WookyDO/Cerbo-alde/hardware/BOM.csv

Referenzen | Anzahl | Wert | Footprint | LCSC | Hersteller-Teil | Hersteller | Bestueckung
SW1, SW2 | 2 | B3U-1000P | SW_SPST_B3U-1000P | C231329 | B3U-1000P | Omron | JLCPCB
D3 | 1 | B5819W | D_SOD-123 | C109213 | B5819W | MDD | JLCPCB
R5, R17 | 2 | 4.7kΩ | R_0603_1608Metric | C23162 | 0603WAF4701T5E | UNI-ROYAL | JLCPCB
C6, C7 | 2 | 22uF 25V X5R | C_1206_3216Metric | C12891 | CL31A226KAHNNNE | Samsung | JLCPCB
U1 | 1 | ESP32-C3 Modul | ESP32-C3-WROOM-02 |  | ESP32-C3-WROOM-02-N4 | Espressif | selbst beschaffen/loeten
C1, C4, C5, C8, C9, C13, C17 | 7 | 100nF 50V X7R | C_0603_1608Metric | C14663 | CC0603KRX7R9BB104 | YAGEO | JLCPCB
R6, R8, R9, R10, R11, R18 | 6 | 10kΩ | R_0603_1608Metric | C25804 | 0603WAF1002T5E | UNI-ROYAL | JLCPCB
J4 | 1 | Stiftleiste 1x6 2,54 mm | PinHeader_1x06_P2.54mm_Vertical |  | PREC006SAAN-RC | Sullins | selbst beschaffen/loeten
JP1 | 1 | Stiftleiste 1x2 2,54 mm | PinHeader_1x02_P2.54mm_Vertical |  | PREC002SAAN-RC | Sullins | selbst beschaffen/loeten
C3, C16 | 2 | 10uF 50V X7R | C_1210_3225Metric | C138687 | CL32B106KBJNNNE | Samsung | JLCPCB
R13, R14 | 2 | 5.1kΩ | R_0603_1608Metric | C23186 | 0603WAF5101T5E | UNI-ROYAL | JLCPCB
J2, J5 | 2 | Schraubklemme 3-pol. 5,08 mm | TerminalBlock_Phoenix_MKDS-1,5-3-5.08_1x03_P5.08mm_Horizontal |  | 1715734 | Phoenix Contact | selbst beschaffen/loeten
J6, J7 | 2 | RJ12 6P6C liegend | TYCO_5555165-1 |  | 5555165-1 | TE Connectivity | selbst beschaffen/loeten
D5, D8 | 2 | PESD1LIN | D_SOD-323 | C393615 | PESD1LIN | DOWO | JLCPCB
F1 | 1 | PTC 0.5A 60V | Fuse_1812_4532Metric | C19078719 | 1812L050/60GR | Littelfuse | JLCPCB
L2 | 1 | 3.9uH | L_Bourns-SRN4018 | C96899 | SWPA4030S3R9MT | Sunlord | JLCPCB
J3 | 1 | TYPE-C-31-M-12 | USB_C_Receptacle_HRO_TYPE-C-31-M-12 | C165948 | TYPE-C-31-M-12 | Korean Hroparts | JLCPCB
C2 | 1 | 47uF 35V | CP_Elec_6.3x7.7 | C122665 | VEJ470M1VTR-0607 | Lelon | JLCPCB
U4 | 1 | USBLC6-2SC6 | SOT-23-6 | C21713975 | USBLC6-2SC6 | ST | JLCPCB
D4 | 1 | 1N4148W | D_SOD-123 | C109203 | 1N4148W | MDD | JLCPCB
R3 | 1 | 15kΩ | R_0603_1608Metric | C22809 | 0603WAF1502T5E | UNI-ROYAL | JLCPCB
U3, U5 | 2 | TJA1021T/20 | SOIC-8_3.9x4.9mm_P1.27mm | C128810 | TJA1021T/20/CM,118 | NXP | JLCPCB
D6 | 1 | LED green | LED_0603_1608Metric | C125094 | LTST-C190KGKT | Lite-On | JLCPCB
D1 | 1 | SS34 | D_SMA | C115205 | SS34 | MDD | JLCPCB
C11 | 1 | 1nF/50V | C_0603_1608Metric | C1588 | CL10B102KB8NNNC | Samsung | NICHT bestuecken
R7 | 1 | 1kΩ 0.25W | R_1206_3216Metric | C4410 | 1206W4F1001T5E | UNI-ROYAL | JLCPCB
L1 | 1 | 10uH | L_Bourns_SRN6045TA | C135304 | SMNR6045-100MT | Sunlord | JLCPCB
U2 | 1 | AP63203WU-7 | TSOT-23-6 | C780769 | AP63203WU-7 | Diodes | JLCPCB
C10, C18 | 2 | 220pF 50V X7R | C_0603_1608Metric | C1603 | CL10B221KB8NNNC | Samsung | JLCPCB
D2 | 1 | SMBJ18CA | D_SMB | C113991 | SMBJ18CA | Littelfuse/LGE | JLCPCB
C12 | 1 | 10uF 25V X5R | C_0805_2012Metric | C15850 | CL21A106KAYNNNE | Samsung | JLCPCB
C14, C15 | 2 | 1uF 50V X5R | C_0603_1608Metric | C15849 | CL10A105KB8NNNC | Samsung | JLCPCB
R2 | 1 | 100kΩ | R_0603_1608Metric | C25803 | 0603WAF1003T5E | UNI-ROYAL | JLCPCB
D7 | 1 | LED red | LED_0603_1608Metric | C2286 | KT-0603R | Hubei KENTO | JLCPCB
R4, R12 | 2 | 1kΩ | R_0603_1608Metric | C21190 | 0603WAF1001T5E | UNI-ROYAL | JLCPCB
J1 | 1 | Schraubklemme 2-pol. 5,08 mm | TerminalBlock_Phoenix_MKDS-1,5-2-5.08_1x02_P5.08mm_Horizontal |  | 1715721 | Phoenix Contact | selbst beschaffen/loeten
