WookyDO/Cerbo-alde/hardware/gehaeuse/Rev4_Deckel.stl

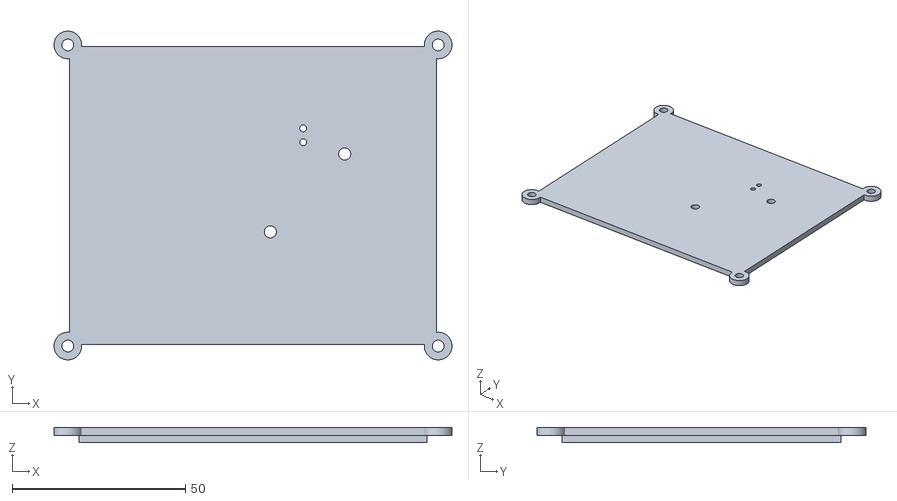
[picture p1: CAD file, 2026-11-14]
hardware/gehaeuse/Rev4_Deckel.stl
115.0 x 95.0 x 4.40
