WookyDO/Cerbo-alde/hardware/gehaeuse/Rev4_Unterteil.stl

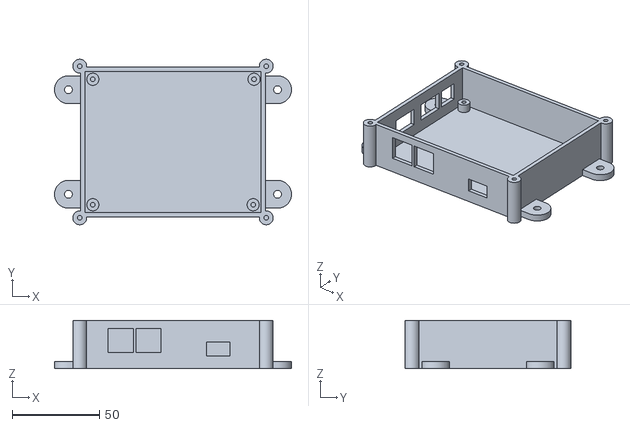
[picture p2: CAD file, 2026-11-14]
hardware/gehaeuse/Rev4_Unterteil.stl
136.0 x 95.0 x 27.6
