WookyDO/Cerbo-alde/hardware/Schaltplan.pdf

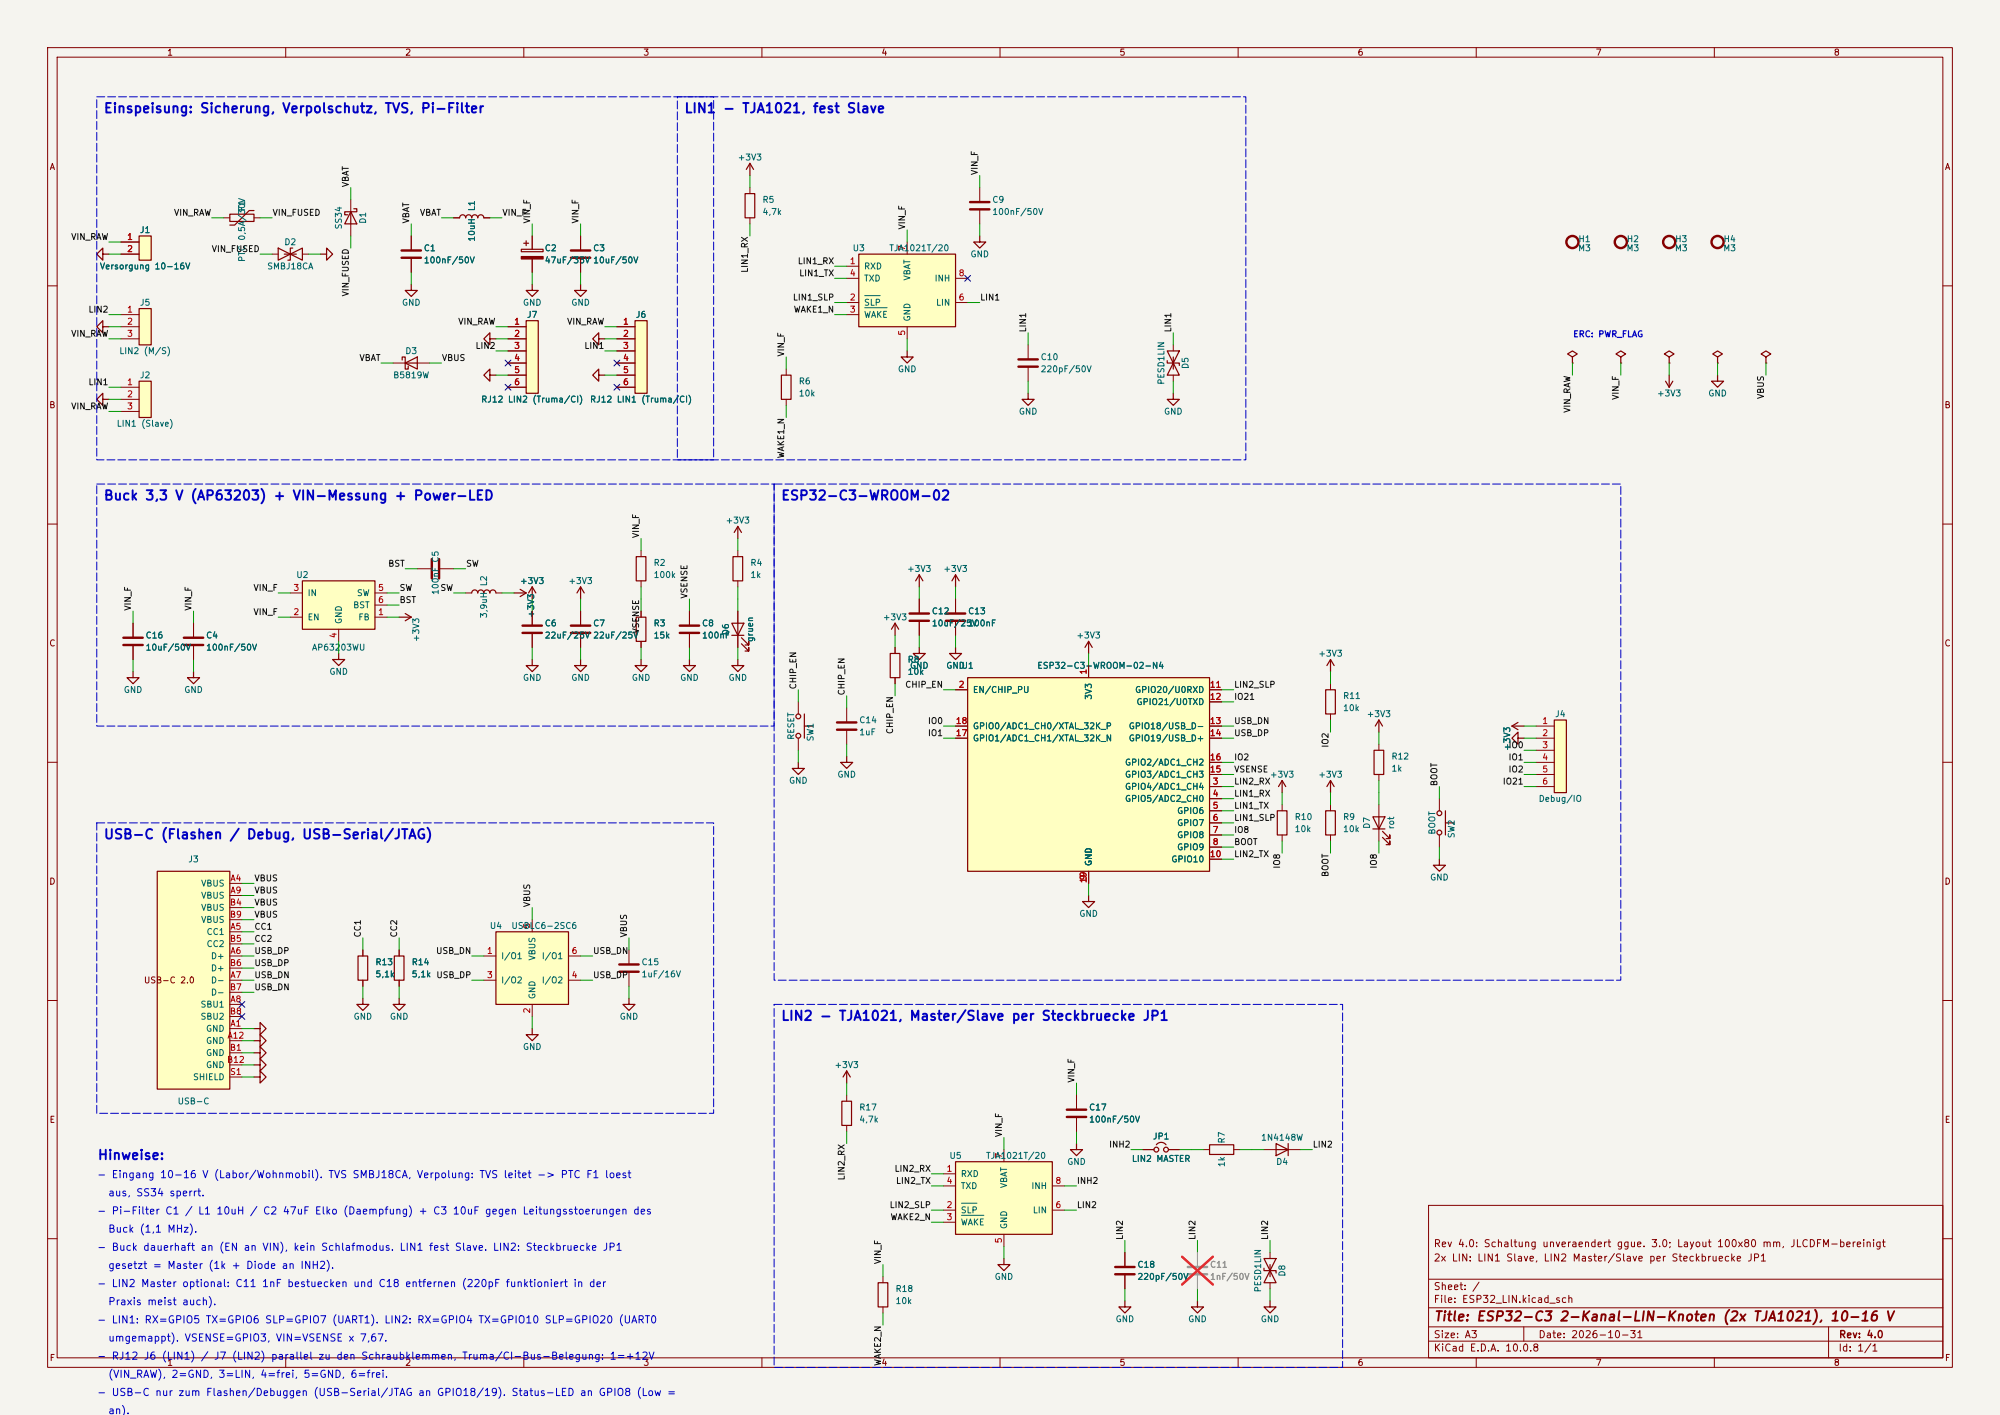
[picture p3: page 1]

Einspeisung: Sicherung, Verpolschutz, TVS, Pi-Filter

Buck 3,3 V (AP63203) + VIN-Messung + Power-LED

IO21 - RJ12 J6 (LIN1) / J7 (LIN2) parallel zu den Schraubklemmen, Truma/CI-Bus-Belegung: 1=+12V - Eingang 10-16 V (Labor/Wohnmobil). TVS SMBJ18CA, Verpolung: TVS leitet -> PTC F1 loest

USB-C (Flashen / Debug, USB-Serial/JTAG)
J3 USB-C

LIN2 - TJA1021, Master/Slave per Steckbruecke JP1

Hinweise: - LIN1: RX=GPIO5 TX=GPIO6 SLP=GPIO7 (UART1). LIN2: RX=GPIO4 TX=GPIO10 SLP=GPIO20 (UART0 - LIN2 Master optional: C11 1nF bestuecken und C18 entfernen (220pF funktioniert in der - Buck dauerhaft an (EN an VIN), kein Schlafmodus. LIN1 fest Slave. LIN2: Steckbruecke JP1

Buck (1,1 MHz). aus, SS34 sperrt. - USB-C nur zum Flashen/Debuggen (USB-Serial/JTAG an GPIO18/19). Status-LED an GPIO8 (Low =
umgemappt). VSENSE=GPIO3, VIN=VSENSE x 7,67. - Pi-Filter C1 / L1 10uH / C2 47uF Elko (Daempfung) + C3 10uF gegen Leitungsstoerungen des

Rev 4.0: Schaltung unveraendert ggue. 3.0; Layout 100x80 mm, JLCDFM-bereinigt
2x LIN: LIN1 Slave, LIN2 Master/Slave per Steckbruecke JP1

gesetzt = Master (1k + Diode an INH2).

Sheet: /
File: ESP32_LIN.kicad_sch
Title: ESP32-C3 2-Kanal-LIN-Knoten (2x TJA1021), 10-16 V

Size: A3 | Rev: 4.0 | F Date: 2026-10-31
KiCad E.D.A. 10.0.8 | Id: 1/1

(VIN_RAW), 2=GND, 3=LIN, 4=frei, 5=GND, 6=frei.
