WookyDO/Cerbo-alde/hardware/ESP32_LIN.kicad_pcb

## KiCad design hardware/ESP32_LIN.kicad_pcb (2026-11-10)

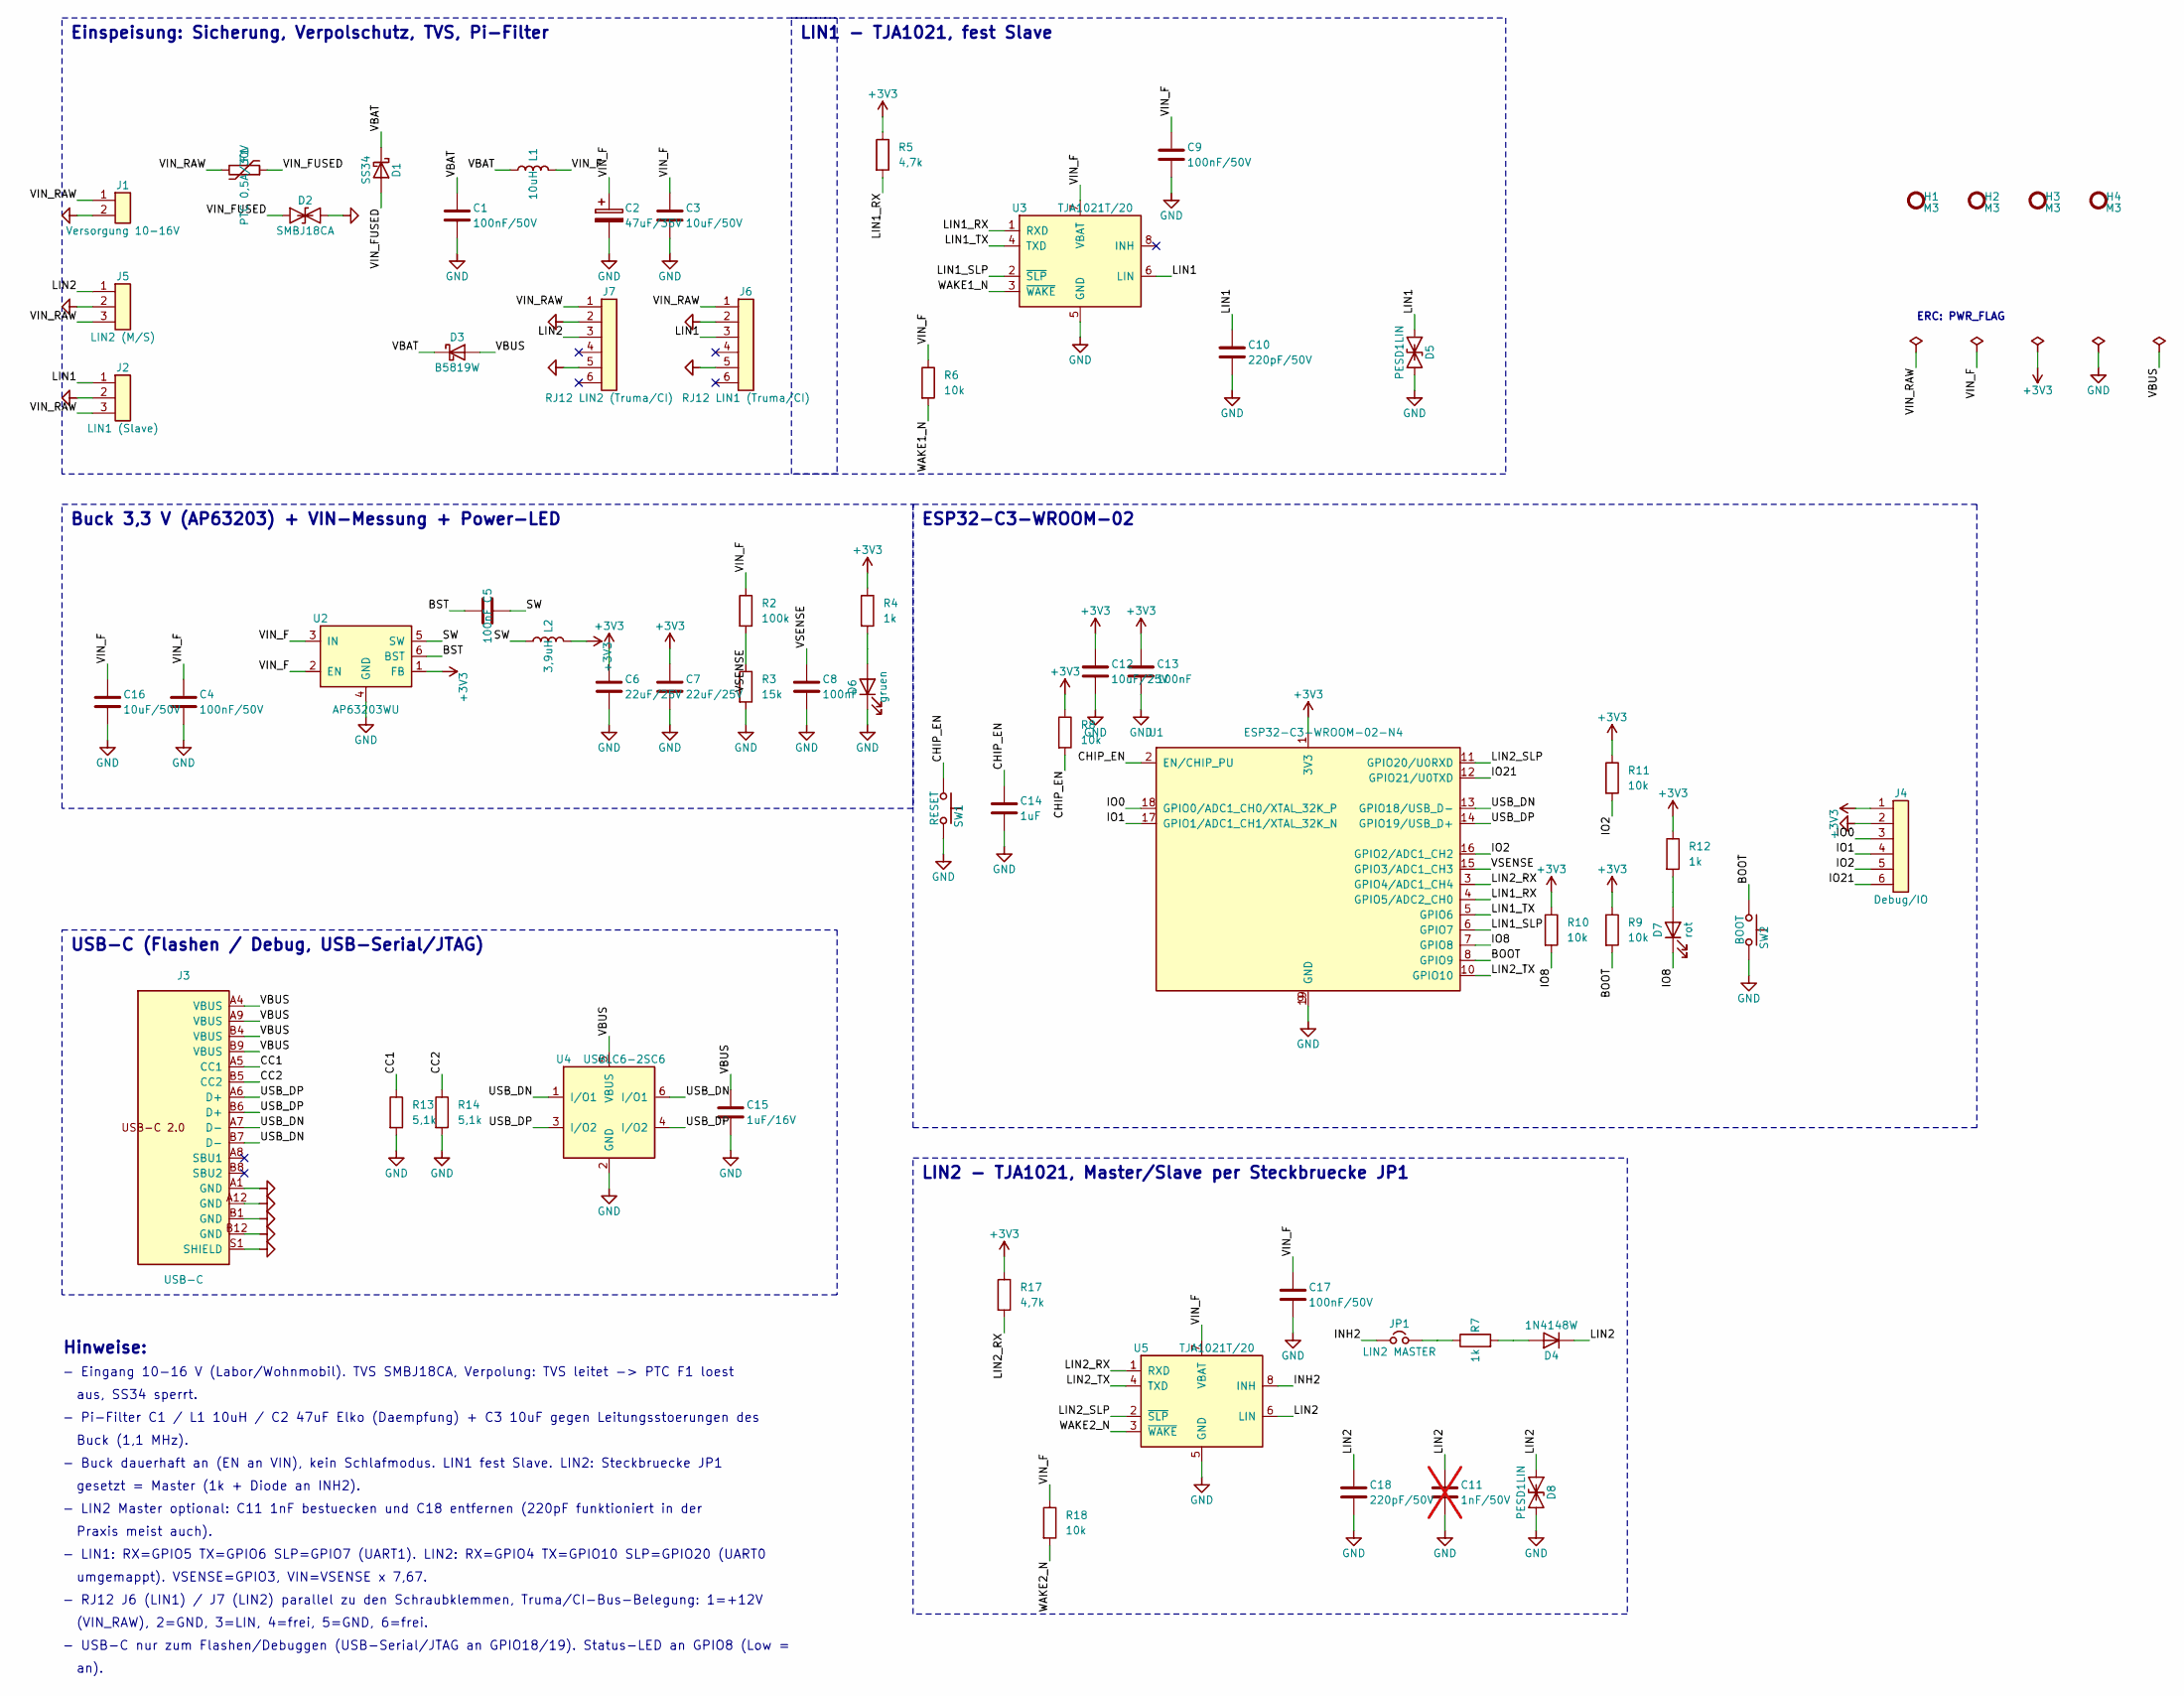
[picture p4: schematic ESP32_LIN.kicad_sch, ESP32-C3 2-Kanal-LIN-Knoten (2x TJA1021), 10-16 V]

Parts:
C1, C4, C9, C17: 100nF/50V; C_0603_1608Metric; MPN CC0603KRX7R9BB104; LCSC C14663
C2: 47uF/35V; CP_Elec_6.3x7.7; MPN VEJ470M1VTR-0607; LCSC C122665
C3, C16: 10uF/50V; C_1210_3225Metric; MPN CL32B106KBJNNNE; LCSC C138687
C5, C8, C13: 100nF; C_0603_1608Metric; MPN CC0603KRX7R9BB104; LCSC C14663
C6, C7: 22uF/25V; C_1206_3216Metric; MPN CL31A226KAHNNNE; LCSC C12891
C10, C18: 220pF/50V; C_0603_1608Metric; MPN CL10B221KB8NNNC; LCSC C1603
C11: 1nF/50V; C_0603_1608Metric; MPN CL10B102KB8NNNC; LCSC C1588; not fitted
C12: 10uF/25V; C_0805_2012Metric; MPN CL21A106KAYNNNE; LCSC C15850
C14: 1uF; C_0603_1608Metric; MPN CL10A105KB8NNNC; LCSC C15849
C15: 1uF/16V; C_0603_1608Metric; MPN CL10A105KB8NNNC; LCSC C15849
D1: SS34; D_SMA; MPN SS34; LCSC C115205
D2: SMBJ18CA; D_SMB; MPN SMBJ18CA; LCSC C113991
D3: B5819W; D_SOD-123; MPN B5819W; LCSC C109213
D4: 1N4148W; D_SOD-123; MPN 1N4148W; LCSC C109203
D5, D8: PESD1LIN; D_SOD-323; MPN PESD1LIN; LCSC C393615
D6: gruen; LED_0603_1608Metric; MPN LTST-C190KGKT; LCSC C125094
D7: rot; LED_0603_1608Metric; MPN KT-0603R; LCSC C2286
F1: PTC 0,5A/30V; Fuse_1812_4532Metric; MPN 1812L050/60GR; LCSC C19078719
H1, H2, H3, H4: M3; MountingHole_3.2mm_M3
J1: Versorgung 10-16V; TerminalBlock_Phoenix_MKDS-1,5-2-5.08_1x02_P5.08mm_Horizont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; MPN KF128-5.08-2P-AA; LCSC C474952
J2: LIN1 (Slave); TerminalBlock_Phoenix_MKDS-1,5-3-5.08_1x03_P5.08mm_Horizont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; MPN KF128-5.08-3P-AA; LCSC C474953
J3: USB-C; USB_C_Receptacle_HRO_TYPE-C-31-M-12; MPN TYPE-C-31-M-12; LCSC C165948
J4: Debug/IO; PinHeader_1x06_P2.54mm_Vertical; MPN B-2100S06P-A110; LCSC C124380
J5: LIN2 (M/S); TerminalBlock_Phoenix_MKDS-1,5-3-5.08_1x03_P5.08mm_Horizont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; MPN KF128-5.08-3P-AA; LCSC C474953
J6: RJ12 LIN1 (Truma/CI); TYCO_5555165-1; MPN 5555165-1; LCSC C305981
J7: RJ12 LIN2 (Truma/CI); TYCO_5555165-1; MPN 5555165-1; LCSC C305981
JP1: LIN2 MASTER; PinHeader_1x02_P2.54mm_Vertical; MPN B-2100S02P-A110; LCSC C124375
L1: 10uH; L_Bourns_SRN6045TA; MPN SMNR6045-100MT; LCSC C135304
L2: 3,9uH; L_Bourns-SRN4018; MPN SWPA4030S3R9MT; LCSC C96899
R2: 100k; R_0603_1608Metric; MPN 0603WAF1003T5E; LCSC C25803
R3: 15k; R_0603_1608Metric; MPN 0603WAF1502T5E; LCSC C22809
R4, R12: 1k; R_0603_1608Metric; MPN 0603WAF1001T5E; LCSC C21190
R5, R17: 4,7k; R_0603_1608Metric; MPN 0603WAF4701T5E; LCSC C23162
R6, R8, R9, R10, R11, R18: 10k; R_0603_1608Metric; MPN 0603WAF1002T5E; LCSC C25804
R7: 1k; R_1206_3216Metric; MPN 1206W4F1001T5E; LCSC C4410
R13, R14: 5,1k; R_0603_1608Metric; MPN 0603WAF5101T5E; LCSC C23186
SW1: RESET; SW_SPST_B3U-1000P; MPN B3U-1000P; LCSC C231329
SW2: BOOT; SW_SPST_B3U-1000P; MPN B3U-1000P; LCSC C231329
U1: ESP32-C3-WROOM-02-N4; ESP32-C3-WROOM-02; MPN ESP32-C3-WROOM-02-N4
U2: AP63203WU; TSOT-23-6; MPN AP63203WU-7; LCSC C780769
U3, U5: TJA1021T/20; SOIC-8_3.9x4.9mm_P1.27mm; MPN TJA1021T/20/CM,118; LCSC C128810
U4: USBLC6-2SC6; SOT-23-6; MPN USBLC6-2SC6; LCSC C21713975

Connections:
+3V3: C6.1, C7.1, C12.1, C13.1, J4.1, L2.2, R4.1, R5.1, R8.1, R9.1, R10.1, R11.1, R12.1, R17.1, U1.1 (3V3), U2.1 (FB)
BOOT: R9.2, SW2.1, U1.8 (GPIO9)
BST: C5.1, U2.6 (BST)
CC1: J3.A5 (CC1), R13.1
CC2: J3.B5 (CC2), R14.1
CHIP_EN: C14.1, R8.2, SW1.1, U1.2 (EN/CHIP_PU)
GND: C1.2, C2.2, C3.2, C4.2, C6.2, C7.2, C8.2, C9.2, C10.2, C11.2, C12.2, C13.2, C14.2, C15.2, C16.2, C17.2, C18.2, D2.2 (A2), D5.2 (A2), D6.1 (K), D8.2 (A2), J1.2, J2.2, J3.A1 (GND), J3.A12 (GND), J3.B1 (GND), J3.B12 (GND), J3.S1 (SHIELD), J4.2, J5.2, J6.2, J6.5, J7.2, J7.5, R3.2, R13.2, R14.2, SW1.2, SW2.2, U1.9 (GND), U1.19 (GND), U2.4 (GND), U3.5 (GND), U4.2 (GND), U5.5 (GND)
INH2: JP1.1 (A), U5.8 (INH)
IO0: J4.3, U1.18 (GPIO0/ADC1_CH0/XTAL_32K_P)
IO1: J4.4, U1.17 (GPIO1/ADC1_CH1/XTAL_32K_N)
IO2: J4.5, R11.2, U1.16 (GPIO2/ADC1_CH2)
IO8: D7.1 (K), R10.2, U1.7 (GPIO8)
IO21: J4.6, U1.12 (GPIO21/U0TXD)
LIN1: C10.1, D5.1 (A1), J2.1, J6.3, U3.6 (LIN)
LIN1_RX: R5.2, U1.4 (GPIO5/ADC2_CH0), U3.1 (RXD)
LIN1_SLP: U1.6 (GPIO7), U3.2 (~SLP)
LIN1_TX: U1.5 (GPIO6), U3.4 (TXD)
LIN2: C11.1, C18.1, D4.1 (K), D8.1 (A1), J5.1, J7.3, U5.6 (LIN)
LIN2_PU: JP1.2 (B), R7.1
LIN2_PU2: D4.2 (A), R7.2
LIN2_RX: R17.2, U1.3 (GPIO4/ADC1_CH4), U5.1 (RXD)
LIN2_SLP: U1.11 (GPIO20/U0RXD), U5.2 (~SLP)
LIN2_TX: U1.10 (GPIO10), U5.4 (TXD)
PWR_LED: D6.2 (A), R4.2
STAT_LED: D7.2 (A), R12.2
SW: C5.2, L2.1, U2.5 (SW)
USB_DN: J3.A7 (D-), J3.B7 (D-), U1.13 (GPIO18/USB_D-), U4.1 (I/O1), U4.6 (I/O1)
USB_DP: J3.A6 (D+), J3.B6 (D+), U1.14 (GPIO19/USB_D+), U4.3 (I/O2), U4.4 (I/O2)
VBAT: C1.1, D1.1 (K), D3.1 (K), L1.1
VBUS: C15.1, D3.2 (A), J3.A4 (VBUS), J3.A9 (VBUS), J3.B4 (VBUS), J3.B9 (VBUS), U4.5 (VBUS)
VIN_F: C2.1, C3.1, C4.1, C9.1, C16.1, C17.1, L1.2, R2.1, R6.1, R18.1, U2.2 (EN), U2.3 (IN), U3.7 (VBAT), U5.7 (VBAT)
VIN_FUSED: D1.2 (A), D2.1 (A1), F1.2
VIN_RAW: F1.1, J1.1, J2.3, J5.3, J6.1, J7.1
VSENSE: C8.1, R2.2, R3.1, U1.15 (GPIO3/ADC1_CH3)
WAKE1_N: R6.2, U3.3 (~WAKE)
WAKE2_N: R18.2, U5.3 (~WAKE)

Notes on the sheet:
ERC: PWR_FLAG
Einspeisung: Sicherung, Verpolschutz, TVS, Pi-Filter
Buck 3,3 V (AP63203) + VIN-Messung + Power-LED
LIN1 - TJA1021, fest Slave
LIN2 - TJA1021, Master/Slave per Steckbruecke JP1
ESP32-C3-WROOM-02
USB-C (Flashen / Debug, USB-Serial/JTAG)
Hinweise:
- Eingang 10-16 V (Labor/Wohnmobil). TVS SMBJ18CA, Verpolung: TVS leitet -> PTC F1 loest
aus, SS34 sperrt.
- Pi-Filter C1 / L1 10uH / C2 47uF Elko (Daempfung) + C3 10uF gegen Leitungsstoerungen des
Buck (1,1 MHz).
- Buck dauerhaft an (EN an VIN), kein Schlafmodus. LIN1 fest Slave. LIN2: Steckbruecke JP1
gesetzt = Master (1k + Diode an INH2).
- LIN2 Master optional: C11 1nF bestuecken und C18 entfernen (220pF funktioniert in der
Praxis meist auch).
- LIN1: RX=GPIO5 TX=GPIO6 SLP=GPIO7 (UART1). LIN2: RX=GPIO4 TX=GPIO10 SLP=GPIO20 (UART0
umgemappt). VSENSE=GPIO3, VIN=VSENSE x 7,67.
- RJ12 J6 (LIN1) / J7 (LIN2) parallel zu den Schraubklemmen, Truma/CI-Bus-Belegung: 1=+12V
(VIN_RAW), 2=GND, 3=LIN, 4=frei, 5=GND, 6=frei.
- USB-C nur zum Flashen/Debuggen (USB-Serial/JTAG an GPIO18/19). Status-LED an GPIO8 (Low =
an).

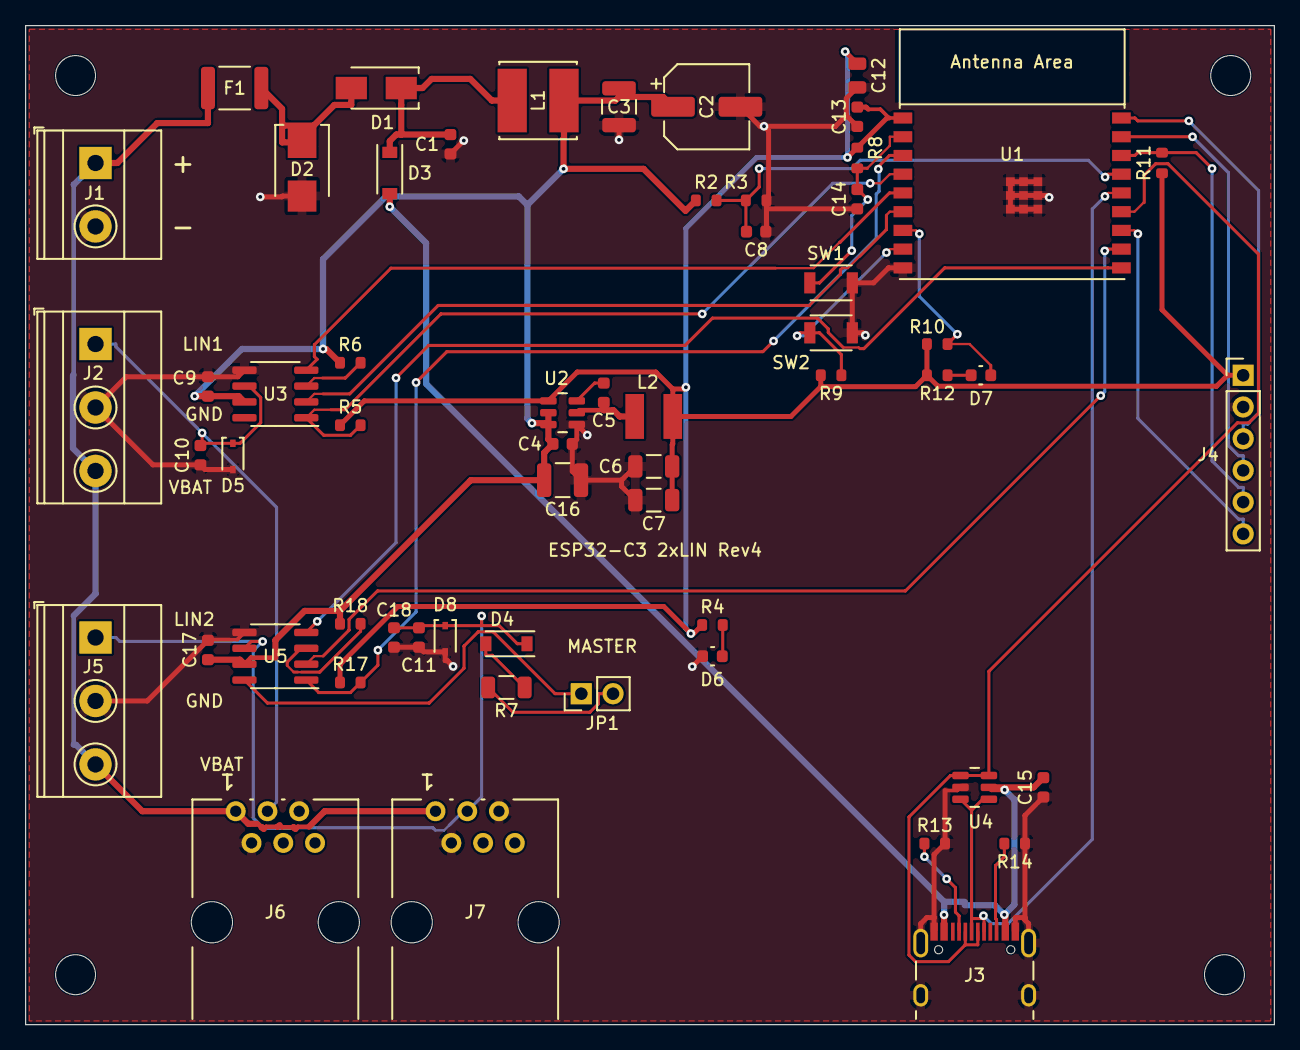
[picture p5: board ESP32_LIN.kicad_pcb from above]

Board: 2 copper layers, 100.0 x 80.0 mm, 63 parts (0 on the bottom side), 36 nets.
