WookyDO/Cerbo-alde/firmware/src/lin_master.h

// LIN-Master auf dem gelben CI-Bus (TJA1021T am UART1).
#pragma once

#include <Arduino.h>

#include "alde_protocol.h"
#include "config.h"
#ifdef HEATER_SIM
#include "alde_sim.h"
#endif

class LinMaster {
 public:
  LinMaster(HardwareSerial &serial, const LinPins &pins) : ser_(serial), pins_(pins) {}

  void begin();
  // Anmeldung beim Panel (Diagnoseframe 0x3C).
  void sendDiag();
  // Info-Frame abfragen; true bei gültiger Antwort.
  bool readInfo(uint8_t data[8]);
  void sendControl(const uint8_t data[8]);
  // Empfangene Bytes verwerfen; Rückgabe: Anzahl (für die Prüfung auf fremden Master).
  uint32_t discardInput();

 private:
  static constexpr uint32_t BAUD = 19200;
  void sendBreak();
  void sendFrame(uint8_t id, const uint8_t data[8]);
  void drain(uint32_t ms);

  HardwareSerial &ser_;
  LinPins pins_;

#ifdef HEATER_SIM
  // Testbetrieb: der Master beantwortet seine Abfragen selbst über den
  // Transceiver und liest Steuer-Frames aus dem eigenen Echo.
  void simAnswerInfo();
  void simReadControlEcho();
  alde::PanelSim sim_;
  uint32_t simLastStep_ = 0;
#endif
};
