WookyDO/Cerbo-alde/(commit log)

2026-10-30 Alde-3030-Plus-Steuerung über WomoLIN-Controller und Cerbo GX
    - firmware/: PlatformIO-Firmware für den WomoLIN LIN-Controller (ESP32).
    LIN-Master am gelben CI-Bus: Anmeldung, Statusabfrage alle 500 ms,
    Steuerframes nur bei Befehl per Read-Modify-Write mit Bestätigung.
    Zeilenprotokoll über TCP (WLAN) und USB-Seriell, OTA-Updates.
    - cerbo/dbus-alde/: Venus-OS-Dienst. Switch-Dienst für die GUI v2
    (Sollwert, Gas, Elektro, Warmwasser) und Temperaturdienste innen/außen.
    Installation unter /data mit Autostart über rc.local.
    - Unit-Tests für Protokoll (C++) und Dienstlogik (Python).
    Claude-Session: https://claude.ai/code/sess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
2026-10-31 Testbetrieb mit simuliertem Alde-Panel (env:womolin_sim)
    Der Controller beantwortet seine LIN-Abfragen selbst über den Transceiver
    und liest Steuer-Frames aus dem eigenen Echo. So lassen sich LIN-Hardware,
    WLAN/TCP und der Cerbo-Dienst ohne angeschlossene Heizung testen.
2026-10-31 WLAN-Stromsparmodus aus, Hysterese im simulierten Panel
    Mit Modem-Sleep verpasste der ESP32 ARP-Anfragen; der Cerbo bekam
    'No route to host'. Das simulierte Panel schaltete am Sollwert bei jeder
    Abfrage die Pumpe um und erzeugte so alle 500 ms eine STATE-Zeile.
2026-10-31 Weboberfläche für Betrieb ohne Cerbo, optionale feste IP
    Die Bridge liefert auf Port 80 eine Seite mit dem Funktionsumfang des
    Cerbo-Dienstes (Anzeige und Steuerung) sowie /api/state und /api/set.
    Befehle laufen über denselben Weg wie TCP/USB. Optional per Passwort
    geschützt (WEB_PASSWORD). STATIC_IP/STATIC_GATEWAY in secrets.h setzen
    eine feste Adresse, sonst DHCP.
2026-10-31 Setup-Seite und Access-Point-Modus statt secrets.h
    WLAN, IP, Access Point und Passwörter liegen im NVS und werden über
    /setup eingestellt. Ohne Einstellungen startet die Bridge als Access
    Point mit Captive Portal; als Betriebsart ist ein dauerhafter Access
    Point wählbar. Ist das WLAN 60 s weg, öffnet sie zusätzlich ihren Access
    Point als Notfall-Zugang.
    Beim Update von einer Version mit secrets.h übernimmt sie die vom
    WLAN-Stack gespeicherten Zugangsdaten, das OTA-Passwort kommt einmalig
    aus ALDE_OTA_PASSWORD beim Bauen. Neue Umgebung womolin_sim_ota.
2026-10-31 Setup: kein Neustart ohne Netzwerkänderung, Seite findet Bridge danach wieder
    Speichern ohne Änderung startete die Bridge neu; danach blieb die Seite
    stehen und verwies nur auf alde-bridge.local, das nicht jedes Gerät
    auflöst. Jetzt: unverändert -> nichts tun, nur Passwörter -> sofort
    übernehmen, sonst Neustart und die Seite wartet auf die IP-Adresse.
2026-10-31 USB-Befehle NET / NET STA / NET AP zum Umschalten der Betriebsart
    Rettungsweg, wenn die Bridge per WLAN nicht erreichbar ist, z.B. im
    dauerhaften Access-Point-Modus. Nur über USB, nicht über TCP.
2026-10-31 Firmware: Truma Combi (CP Plus) als zweiter Heizungstyp
    Der Heizungstyp wird auf der Setup-Seite gewählt. An der Alde bleibt die
    Bridge LIN-Master (Logik unverändert, ausgelagert in AldeHeater), an der
    Truma gibt sie sich als iNet Box aus (LIN-Slave in eigener FreeRTOS-Task,
    9600 Baud, Transport-Layer 0x3C/0x3D, Statuspuffer 0x14/0x33 und
    Befehlspuffer 0x0C/0x32).
    - lib/TrumaProtocol: Puffer, Prüfsumme, Temperaturen, Regeln des CP Plus,
    iNet-Box-Zustandsmaschine und ein simuliertes CP Plus; PC-Tests u.a.
    gegen Referenzwerte aus inetbox.py
    - Alde: vor dem ersten Senden wird der Bus abgehört; sendet bereits ein
    anderer Master (z.B. ein CP Plus), bleibt die Bridge still
    - Weboberflä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
2026-10-31 Cerbo-Dienst dbus-lin-heater für Alde und Truma
    dbus-alde heißt jetzt dbus-lin-heater. Die Heizungen sind Modelle
    (models/alde.py, models/truma.py) mit eigenen Schaltausgängen und
    Temperaturdiensten; der Dienst selbst ist generisch.
    - Typ aus dem HELLO der Bridge (heater=auto): bei abweichendem Typ merkt
    sich der Dienst ihn und startet mit dem passenden Modell neu
    - STATE-Zeilen werden erst nach passendem HELLO ausgewertet
    - Truma: Raumtemperatur mit an/aus, Heizstufe, Warmwasser, Energie und
    Elektroleistung als Dropdowns; Haltezeit 40 s, weil das CP Plus Befehle
    verzögert bestätigt
    - install.sh löst dbus-alde ab und übernimmt dessen config.ini
    - README beschreibt beide Heizung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
2026-10-31 Übergangslösungen für Altinstallationen entfernt
    Es gibt keine Installationen der Vorversionen mehr:
    - Firmware: keine Übernahme der WLAN-Daten aus secrets.h-Zeiten, kein
    Start-OTA-Passwort beim Bauen; OTA läuft erst nach der Einrichtung
    und nie ohne Passwort
    - Cerbo-Dienst: HELLO ohne heater= wird nicht mehr als Alde gedeutet,
    kein Abschnitt [names] mehr, install.sh löst dbus-alde nicht mehr ab
2026-11-01 Cerbo: Truma-Heizung über die Heizstufe ausschaltbar
    Der Temperaturregler der GUI v2 bietet keinen Ausschalter, daher hat die
    Heizstufen-Auswahl jetzt Aus/Eco/Boost. Aus schickt SET mode=off; die
    Firmware setzt daraus Sollwert 0 und Heizstufe aus in einem Puffer, wie
    inetbox.py.
2026-11-09 Firmware: Unterstützung für die ESP32_LIN-Platine
    Neue Umgebungen esp32_lin, esp32_lin_ota, esp32_lin_sim und
    esp32_lin_sim_ota für den ESP32-C3 mit 4 MB Flash.
    - Truma an LIN1, Alde an LIN2; nur der Transceiver der gewählten
    Heizung wird geweckt
    - LIN-Slave-Task auf dem Einkern-C3 nicht mehr fest auf Kern 1
    - Rote Status-LED fasst Heizungs- und Netzstatus zusammen
    - Bordspannung (VSENSE) in Weboberfläche, /api/state, VIN und NET
    - USB-Ausgaben blockieren ohne angeschlossenen Rechner nicht
    Der Spannungswert ist noch nicht abgeglichen und liegt zu hoch.
2026-11-10 Bordspannung abgleichen und glätten, LIN-Prüf-Firmware
    VSENSE: Abgleich aus zwei Multimeter-Messungen an VIN_F, 32 Messungen
    pro Durchlauf und stärkere Glättung (Zeitkonstante etwa 4 s).
    hwtest: eigenständige Prüf-Firmware mit Testskript, die LIN1 und LIN2
    zweier ESP32_LIN-Platinen gegeneinander testet, LIN2 als Master und
    als Slave, mit 9600 und 19200 Baud.
2026-11-10 Bordspannung: Abgleich entfernt, Spannungsabfall gemessen
    Der ADC liefert bei 11 und 12 V den richtigen Wert, der Abgleich aus
    früheren, noch verrauschten Messungen war falsch. Es bleibt der
    gemessene Abfall von 0,24 V über D1 und PTC.
2026-11-10 Hardware: KiCad-Projekt der ESP32_LIN-Platine ins Repo
    Schaltplan, Layout, Bibliotheken und Fertigungsdaten (Rev 4) liegen
    jetzt unter hardware/, neben Firmware und Cerbo-Dienst.
    [BOM.csv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]
2026-11-14 Hardware: 3D-Druck-Gehäuse für die Rev4-Platine (STL)
    Unterteil und Deckel für PLA, aus Onshape exportiert. Vier Laschen
    zur Befestigung auf dem Untergrund (Ø 4,5 mm, Lochbild 120 × 60 mm),
    Platine auf vier Domen (M3 gewindeformend), Deckel mit 4 × M3 × 12.
    Fenster für J1/J2/J5, J6/J7 und USB-C, Löcher für LEDs und
    RESET/BOOT im Deckel. Der Deckel liegt in Einbaulage und muss im
    Slicer umgedreht werden.
    [Rev4_Deckel.stl, Rev4_Unterteil.stl]
